viktorkondratyuk238-cpu/LoRaLess-calc/bom_jlcpcb.csv

Comment | Designator | Footprint | LCSC Part #
10 microfarad | C1,C2 | Capacitor_SMD:C_0805_2012Metric | C15850
100nF | C5,C6 | Capacitor_SMD:C_0603_1608Metric | C14663
10uF | C7 | Capacitor_SMD:C_0805_2012Metric | C15850
4.7uF | C8,C9 | Capacitor_SMD:C_0805_2012Metric | C1779
1uF | C10 | Capacitor_SMD:C_0603_1608Metric | C15849
1N4148 | D1,D2,D3,D4,D5,D6,D7,D8,D9,D10,D11,D12,D13,D14,D15,D16,D17,D18,D19,D20,D21,D22,D23,D24,D25,D26,D27,D28,D29,D30 | Diode_SMD:D_SOD-123 | C81598
USB-C | J1 | Connector_USB:USB_C_Receptacle_HRO_TYPE-C-31-M-12 | C165948
5,1k | R1,R2 | Resistor_SMD:R_0603_1608Metric | C23186
2k | R3 | Resistor_SMD:R_0603_1608Metric | C22975
4.7k | R6,R7 | Resistor_SMD:R_0603_1608Metric | C23162
10k | R8,R9,R10 | Resistor_SMD:R_0603_1608Metric | C25804
SW_Push | SW1,SW2,SW3,SW4,SW5,SW6,SW7,SW8,SW9,SW10,SW11,SW12,SW13,SW14,SW15,SW16,SW17,SW18,SW19,SW20,SW21,SW22,SW23,SW24,SW25,SW26,SW27,SW28,SW29,SW30 | Button_Switch_SMD:SW_Push_1TS009xxxx-xxxx-xxxx_6x6x5mm | C412375
SW_SPDT | SW31 | Button_Switch_SMD:SW_SPDT_Shouhan_MSK12C02 | C431540
MCP23017x-x-SO | U1 | Package_SO:SOIC-28W_7.5x17.9mm_P1.27mm | C47023
MCP73831-2-OT | U3 | Package_TO_SOT_SMD:SOT-23-5 | C424093
ESP32-C3-WROOM-02U | U4 | RF_Module:ESP32-C3-WROOM-02U | C2926676
AP2112K-3.3 | U5 | Package_TO_SOT_SMD:SOT-23-5 | C51118
