viktorkondratyuk238-cpu/LoRaLess-calc/lora-calculator_jlcpcb.kicad_pcb

## KiCad design lora-calculator_jlcpcb.kicad_pcb (2026-11-01)

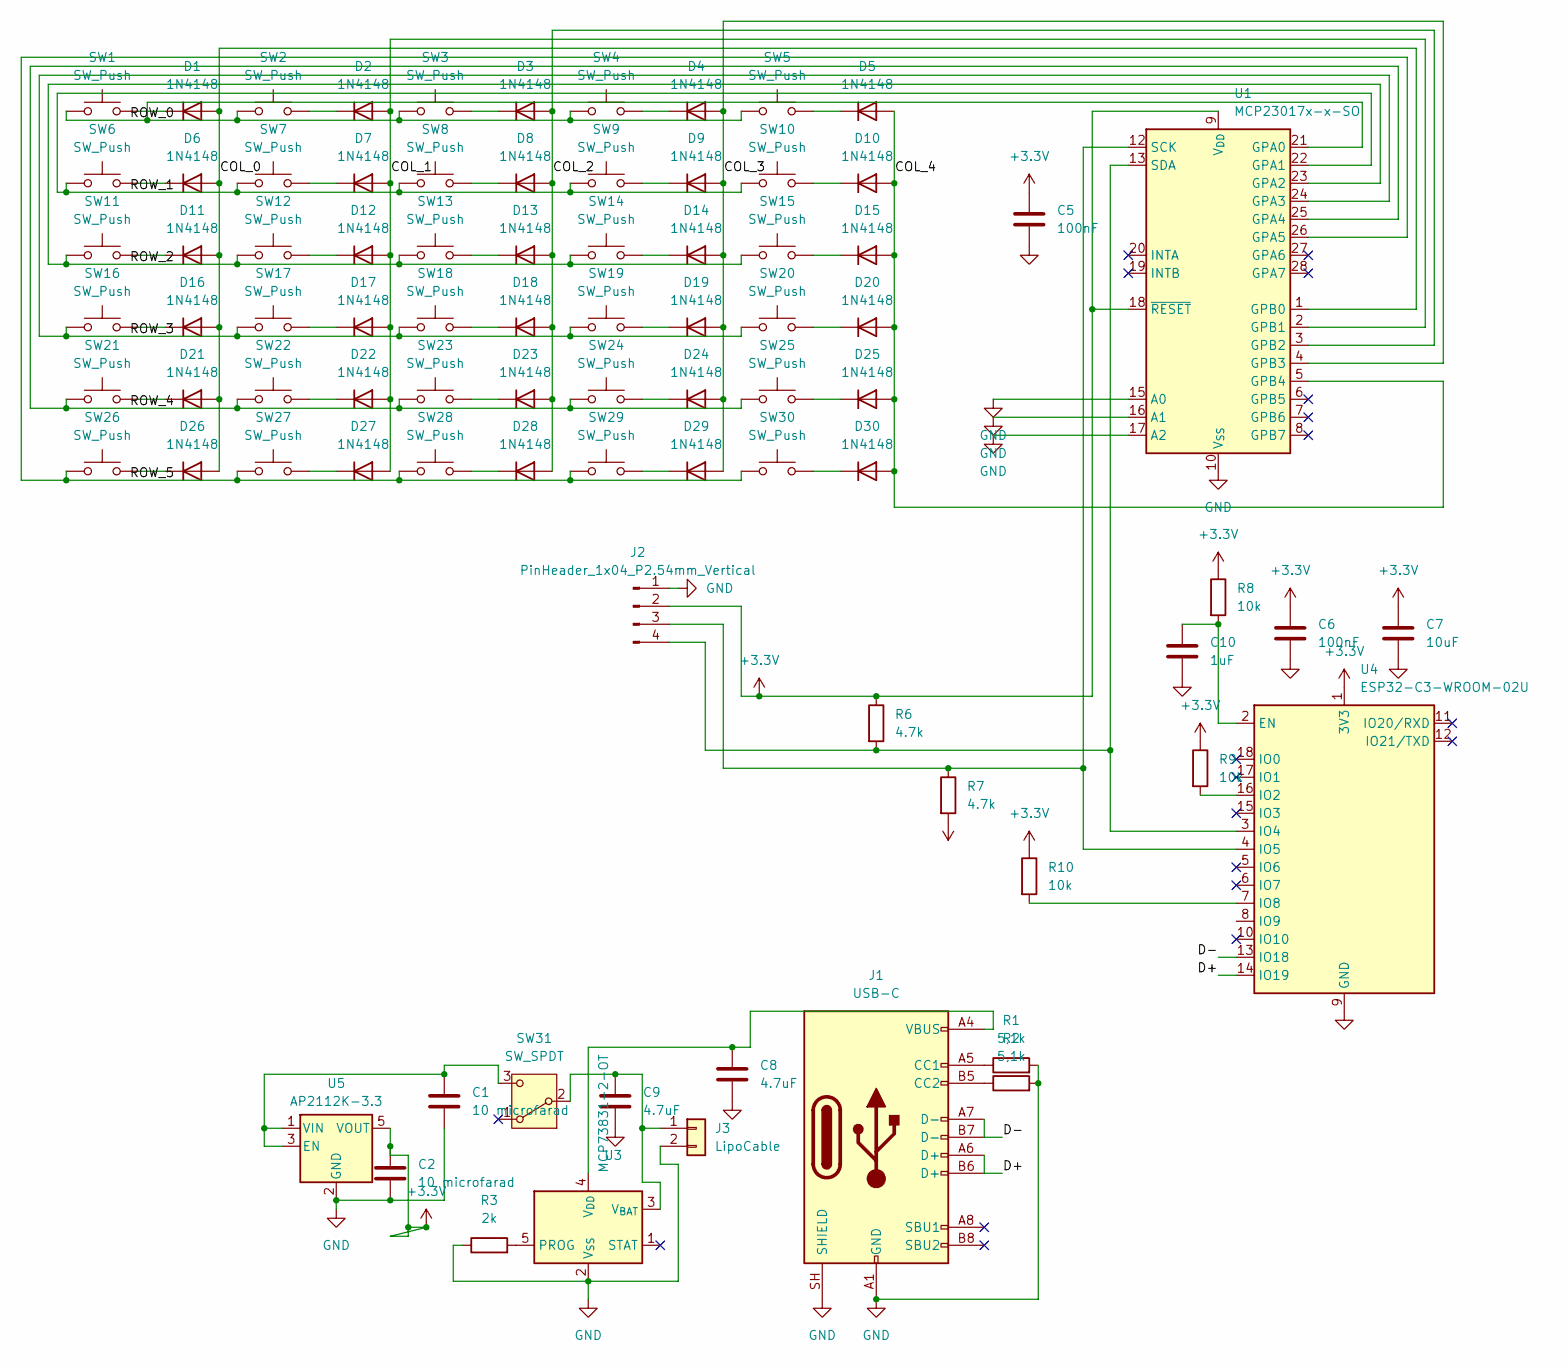
[picture p1: schematic lora-calculator_jlcpcb.kicad_sch]

Parts:
C1, C2: 10 microfarad; C_0805_2012Metric; LCSC C15850
C5, C6: 100nF; C_0603_1608Metric; LCSC C14663
C7: 10uF; C_0805_2012Metric; LCSC C15850
C8, C9: 4.7uF; C_0805_2012Metric; LCSC C1779
C10: 1uF; C_0603_1608Metric; LCSC C15849
D1, D2, D3, D4, D5, D6, D7, D8, D9, D10, D11, D12, D13, D14, D15, D16, D17, D18, D19, D20, D21, D22, D23, D24, D25, D26, D27, D28, D29, D30: 1N4148; D_SOD-123; LCSC C81598
J1: USB-C; USB_C_Receptacle_HRO_TYPE-C-31-M-12; LCSC C165948
J2: PinHeader_1x04_P2.54mm_Vertical
J3: LipoCable; JST_PH_S2B-PH-K_1x02_P2.00mm_Horizontal; LCSC C173752
R1, R2: 5,1k; R_0603_1608Metric; LCSC C23186
R3: 2k; R_0603_1608Metric; LCSC C22975
R6, R7: 4.7k; R_0603_1608Metric; LCSC C23162
R8, R9, R10: 10k; R_0603_1608Metric; LCSC C25804
SW1, SW2, SW3, SW4, SW5, SW6, SW7, SW8, SW9, SW10, SW11, SW12, SW13, SW14, SW15, SW16, SW17, SW18, SW19, SW20, SW21, SW22, SW23, SW24, SW25, SW26, SW27, SW28, SW29, SW30: SW_Push; SW_Push_1TS009xxxx-xxxx-xxxx_6x6x5mm; LCSC C412375
SW31: SW_SPDT; SW_SPDT_Shouhan_MSK12C02; LCSC C431540
U1: MCP23017x-x-SO; SOIC-28W_7.5x17.9mm_P1.27mm; LCSC C47023
U3: MCP73831-2-OT; SOT-23-5; LCSC C424093
U4: ESP32-C3-WROOM-02U; LCSC C2926676
U5: AP2112K-3.3; SOT-23-5; LCSC C51118

Connections:
+3.3V: C2.1, C5.1, C6.1, C7.1, J2.2, R6.1, R7.2, R8.1, R9.1, R10.1, U1.9 (V_{DD}), U1.18 (~RESET), U4.1 (3V3), U5.5 (VOUT)
/COL_0: D1.2 (A), D6.2 (A), D11.2 (A), D16.2 (A), D21.2 (A), D26.2 (A), U1.1 (GPB0)
/COL_1: D2.2 (A), D7.2 (A), D12.2 (A), D17.2 (A), D22.2 (A), D27.2 (A), U1.2 (GPB1)
/COL_2: D3.2 (A), D8.2 (A), D13.2 (A), D18.2 (A), D23.2 (A), D28.2 (A), U1.3 (GPB2)
/COL_3: D4.2 (A), D9.2 (A), D14.2 (A), D19.2 (A), D24.2 (A), D29.2 (A), U1.4 (GPB3)
/COL_4: D5.2 (A), D10.2 (A), D15.2 (A), D20.2 (A), D25.2 (A), D30.2 (A), U1.5 (GPB4)
/D+: J1.A6 (D+), J1.B6 (D+), U4.14 (IO19)
/D-: J1.A7 (D-), J1.B7 (D-), U4.13 (IO18)
/ROW_0: SW1.1, SW2.1, SW3.1, SW4.1, SW5.1, U1.21 (GPA0)
/ROW_1: SW6.1, SW7.1, SW8.1, SW9.1, SW10.1, U1.22 (GPA1)
/ROW_2: SW11.1, SW12.1, SW13.1, SW14.1, SW15.1, U1.23 (GPA2)
/ROW_3: SW16.1, SW17.1, SW18.1, SW19.1, SW20.1, U1.24 (GPA3)
/ROW_4: SW21.1, SW22.1, SW23.1, SW24.1, SW25.1, U1.25 (GPA4)
/ROW_5: SW26.1, SW27.1, SW28.1, SW29.1, SW30.1, U1.26 (GPA5)
GND: C1.2, C2.2, C5.2, C6.2, C7.2, C8.2, C9.2, C10.2, J1.A1 (GND), J1.A12 (GND), J1.B1 (GND), J1.B12 (GND), J1.SH (SHIELD), J2.1, J3.2, R1.2, R2.2, R3.1, U1.10 (V_{SS}), U1.15 (A0), U1.16 (A1), U1.17 (A2), U3.2 (V_{SS}), U4.9 (GND), U4.19 (GND), U5.2 (GND)
unnamed: D1.1 (K), SW1.2
unnamed: D2.1 (K), SW2.2
unnamed: D3.1 (K), SW3.2
unnamed: D4.1 (K), SW4.2
unnamed: D5.1 (K), SW5.2
unnamed: D6.1 (K), SW6.2
unnamed: D7.1 (K), SW7.2
unnamed: D8.1 (K), SW8.2
unnamed: D9.1 (K), SW9.2
unnamed: D10.1 (K), SW10.2
unnamed: D11.1 (K), SW11.2
unnamed: D12.1 (K), SW12.2
unnamed: D13.1 (K), SW13.2
unnamed: D14.1 (K), SW14.2
unnamed: D15.1 (K), SW15.2
unnamed: D16.1 (K), SW16.2
unnamed: D17.1 (K), SW17.2
unnamed: D18.1 (K), SW18.2
unnamed: D19.1 (K), SW19.2
unnamed: D20.1 (K), SW20.2
unnamed: D21.1 (K), SW21.2
unnamed: D22.1 (K), SW22.2
unnamed: D23.1 (K), SW23.2
unnamed: D24.1 (K), SW24.2
unnamed: D25.1 (K), SW25.2
unnamed: D26.1 (K), SW26.2
unnamed: D27.1 (K), SW27.2
unnamed: D28.1 (K), SW28.2
unnamed: D29.1 (K), SW29.2
unnamed: D30.1 (K), SW30.2
unnamed: J1.A5 (CC1), R1.1
unnamed: J1.B5 (CC2), R2.1
unnamed: J2.3, R7.1, U1.12 (SCK), U4.4 (IO5)
unnamed: J2.4, R6.2, U1.13 (SDA), U4.3 (IO4)
unnamed: C9.1, J3.1, SW31.2 (B), U3.3 (V_{BAT})
unnamed: C1.1, SW31.3 (C), U5.1 (VIN), U5.3 (EN)
unnamed: R3.2, U3.5 (PROG)
unnamed: C8.1, J1.A4 (VBUS), J1.A9 (VBUS), J1.B4 (VBUS), J1.B9 (VBUS), U3.4 (V_{DD})
unnamed: C10.1, R8.2, U4.2 (EN)
unnamed: R9.2, U4.16 (IO2)
unnamed: R10.2, U4.7 (IO8)

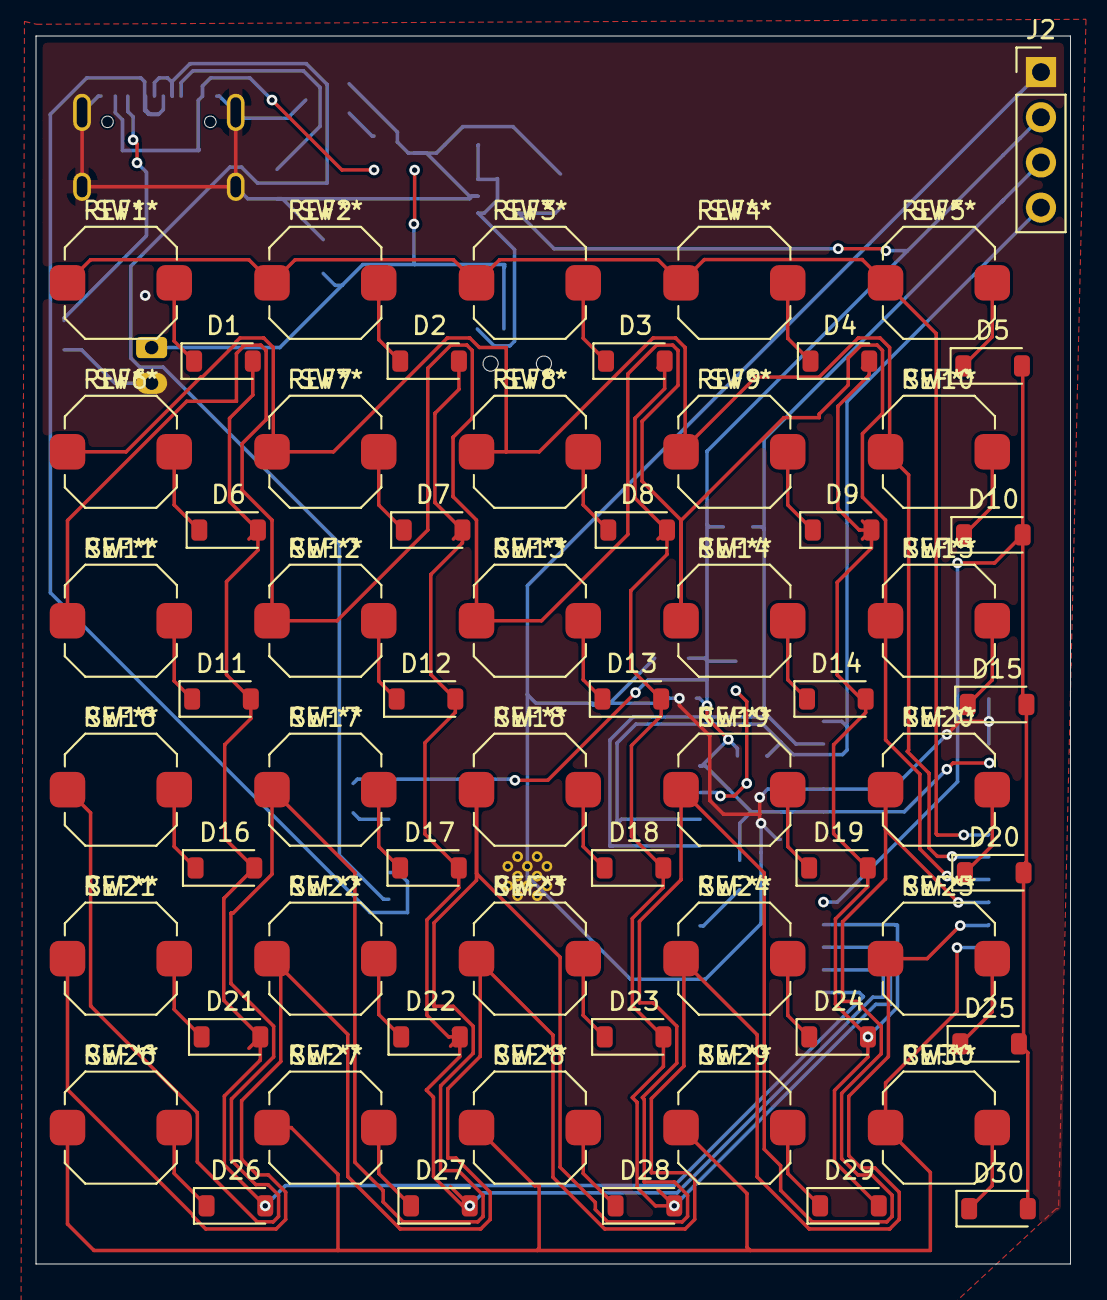
[picture p2: board lora-calculator_jlcpcb.kicad_pcb from above]

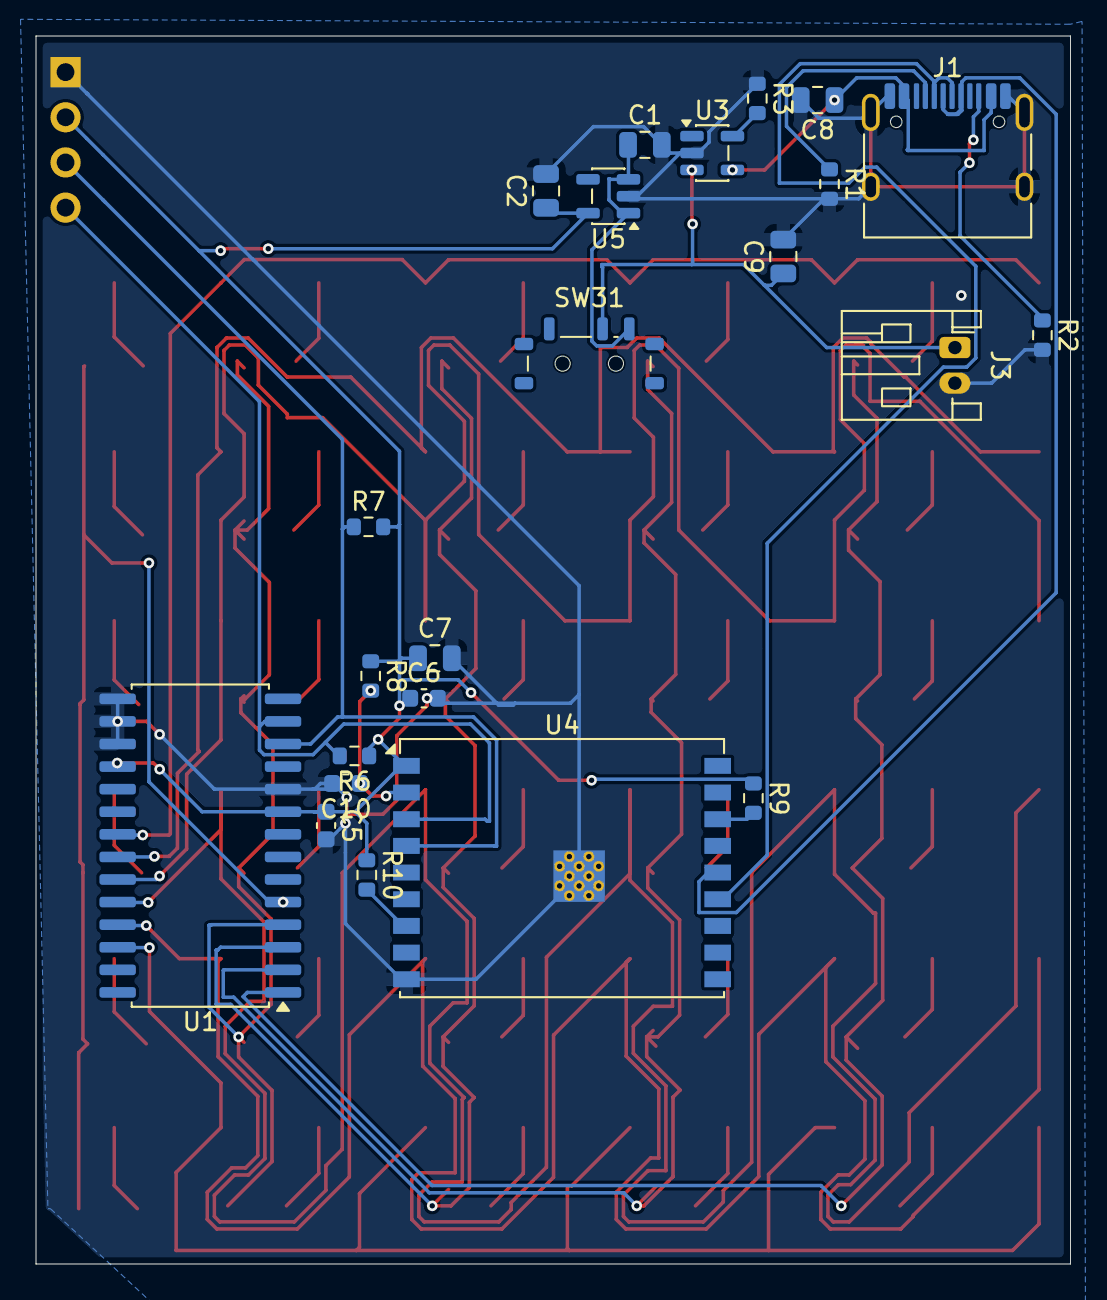
[picture p3: board lora-calculator_jlcpcb.kicad_pcb from below]

Board: 2 copper layers, 58.2 x 69.1 mm, 84 parts (23 on the bottom side), 56 nets.
