viktorkondratyuk238-cpu/LoRaLess-calc/(commit log)

2026-10-30 Initial commit: LoRaLess calculator schematic, BOM, firmware, and tests
    [bom_jlcpcb.csv, lora-calculator_jlcpcb.kicad_sch]
2026-10-30 Correct screen controller to SSD1317 and note the panel size needs confirming
    [display_hw.h]
2026-10-30 Make host tests check real firmware values and work for any board
    - test.cpp now checks each result and exits non-zero on a wrong one
    (it only printed results before).
    - "Syntax error" test checks the text the calculator shows (new calcText()
    in main.cpp) instead of a copy of the string.
    - Unused expander pins are a file-level UNUSED_PIN array in main.cpp, and
    the test checks that array instead of its own copy.
    - Tests pick other boards with peer(k) (test_util.h), so they pass for
    DEVICE_ID 1 to 4. They used to assume board 1.
    - Stubs: Serial output can be silenced, so test_main output is short.
    - Fix stale comments and a no-op loop in test_ui and test_screen.
    - run_tests.sh builds a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
    [main.cpp, test.cpp, test_comm.cpp, test_main.cpp, test_screen.cpp, test_ui.cpp, test_util.h]
2026-10-30 Ignore acks meant for other boards; limit duplicate check to a short window
    [comm.h]
2026-10-30 Add KiCad PCB file generated from the schematic
    [lora-calculator_jlcpcb.kicad_pcb]
2026-10-30 Remove SW32 and SW33 reset/boot buttons
    [bom_jlcpcb.csv, lora-calculator_jlcpcb.kicad_sch]
2026-10-30 Add SSD1317 128x64 driver in place of SSD1306 stand-in
2026-10-30 Update KiCad PCB layout
    [lora-calculator_jlcpcb.kicad_pcb]
2026-10-30 Add KiCad project file and CLAUDE.md working rules
2026-10-31 Fix netcheck.py schematic filename
2026-10-31 Update KiCad schematic
    [lora-calculator_jlcpcb.kicad_sch]
2026-10-31 Document parts outside the PCB BOM in README
2026-10-31 Fix SSD1317 driver note in firmware README
2026-11-01 Fix PCB DRC errors
    [lora-calculator_jlcpcb.kicad_pcb]
